TheEryk/PUT-Motorsport-2018-DRS/At90CAN_Atmel/kartapom/kartapom/opis_ramek_can.ods

Sheet: Karta_Pomiarowa
 |  |  |  |  |  |  |  |  |  | BITY | Mnożnik | ID (HEX) | Częstotliwość |  |  |  |  |  |  |  |  |  |  | BITY | Mnożnik | ID (HEX) | Częstotliwość
Tył |  |  |  |  |  |  |  |  |  |  |  |  |  | Przód
1 | A | Prędkość koła PRAWE |  |  |  |  |  |  |  | 16 bitów | 1 | 2 | 20 | 1 | A | Prędkość koła PRAWE |  |  |  |  |  |  |  | 16 bitów | 1 | 1 | 20
 | B | Prędkość koła LEWE |  |  |  |  |  |  |  | 16 bitów | 1 |  |  |  | B | Prędkość koła LEWE |  |  |  |  |  |  |  | 16 bitów | 1
 | C | Amortyzator PRAWY |  |  |  |  |  |  |  | 10 - 16 bitów | 1 |  |  |  | C | Kąt skrętu kierownicy |  |  |  |  |  |  |  | 10 - 16 bitów | 1
 | D | Amortyzator LEWY |  |  |  |  |  |  |  | 10 - 16 bitów | 1 |  |  |  | D | Przełącznik trakcji |  |  |  |  |  |  |  | 4 - 8 bitów | 1
 |  | 0 | 1 | 2 | 3 | 4 | 5 | 6 | 7 |  |  |  |  |  | E | Switch (Brake, G_UP, G_DOWN) |  |  |  |  |  |  |  | 8 bitów | 1
Ramka: |  | A |  | B |  | C |  | D |  |  |  |  |  |  |  | 0 | 1 | 2 | 3 | 4 | 5 | 6 | 7
 |  |  |  |  |  |  |  |  |  |  |  |  |  | Ramka: |  | A |  | B |  | C |  | D | E
Tył |  |  |  |  |  |  |  |  |  |  |  |  |  | Przód
2 | A | Temperatura chłodnicy WEJŚCIE |  |  |  |  |  |  |  | 10 - 16 bitów | 1 | 7 | 10 | 2 | A | Amortyzator PRAWY |  |  |  |  |  |  |  | 10 - 16 bitów | 1 | 6 | 20
 | B | Temperatura chłodnicy WYJŚCIE |  |  |  |  |  |  |  | 10 - 16 bitów | 1 |  |  |  | B | Amortyzator LEWY |  |  |  |  |  |  |  | 10 - 16 bitów | 1
 | C | Ciśnienie paliwa |  |  |  |  |  |  |  | 10 - 16 bitów | 1 |  |  |  | C | Ciśnienie hamulca przód |  |  |  |  |  |  |  | 10 - 16 bitów | 1
 | D | Ciśnienie w układzie hamulcowym |  |  |  |  |  |  |  | 10 - 16 bitów | 1 |  |  |  | D | Ciśnienie hamulca tył |  |  |  |  |  |  |  | 10 - 16 bitów | 1
 |  | 0 | 1 | 2 | 3 | 4 | 5 | 6 | 7 |  |  |  |  |  |  | 0 | 1 | 2 | 3 | 4 | 5 | 6 | 7
Ramka: |  | A |  | B |  | C |  | D |  |  |  |  |  | Ramka: |  | A |  | B |  | C |  | D
Tył |  |  |  |  |  |  |  |  |  |  |  |  |  | Przód
3 | A | Prędkość koła (przeliczone) PRAWE |  |  |  |  |  |  |  | 16 bitów | 1 | 9 | 10 | 3 | A | Prędkość koła (przeliczone) PRAWE |  |  |  |  |  |  |  | 8 bitów | 1 | 8 | 10
 | B | Prędkość koła (przeliczone) LEWE |  |  |  |  |  |  |  | 16 bitów | 1 |  |  |  | B | Prędkość koła (przeliczone) LEWE |  |  |  |  |  |  |  | 8 bitów | 1
 | C |  |  |  |  |  |  |  |  |  |  |  |  |  | C | Kąt skrętu kierownicy (przeliczona) |  |  |  |  |  |  |  | 7 bitów znak | 1
 |  | 0 | 1 | 2 | 3 | 4 | 5 | 6 | 7 |  |  |  |  |  | D | Czy Automatyczna zmiana biegó ACC |  |  |  |  |  |  |  | 8 bit | 1
Ramka: |  | A |  | B |  | C |  |  |  |  |  |  |  |  |  | 0 | 1 | 2 | 3 | 4 | 5 | 6 | 7
Ramka: |  | A |  | B |  | C |  | D | E |  |  |  |  | Ramka: |  | A |  | B |  | C |  | D | E

Sheet: EMU
 |  |  |  |  |  |  |  |  |  | BITY | Mnożnik | ID (HEX) | Częstotliwość | Odbierany stream
EMU |  |  |  |  |  |  |  |  |  |  |  |  |  |  |  |  |  |  |  |  |  |  |  | BITY | ID (HEX)
1 | A | Temperatura oleju |  |  |  |  |  |  |  | 8 bitów | 1 | 5 | 10 | EMU1 karta pomiarowa przód
 | B |  |  |  |  |  |  |  |  |  |  |  |  | 1 | A | Prędkość koła PRAWE |  |  |  |  |  |  |  | 16 bitów | 1
 | C | CLT |  |  |  |  |  |  |  | 16 bitów | 1 |  |  |  | B | Prędkość koła LEWE |  |  |  |  |  |  |  | 16 bitów
 | D | Gear |  |  |  |  |  |  |  | 8 bitów | 1 |  |  |  | C
 |  | 0 | 1 | 2 | 3 | 4 | 5 | 6 | 7 |  |  |  |  |  | D
Ramka: |  | A | B | C |  | D |  |  |  |  |  |  |  |  | E | Sift Switch |  |  |  |  |  |  |  | 8 bitów
 |  |  |  |  |  |  |  |  |  |  |  |  |  |  |  | 0 | 1 | 2 | 3 | 4 | 5 | 6 | 7
 |  |  |  |  |  |  |  |  |  |  |  |  |  | Ramka: |  | A |  | B |  |  |  |  | E
EMU
2 | A | RPM |  |  |  |  |  |  |  | 16 bitów | 1 | 4 | 20 | EMU2 karta pom tył
 | B | TPS |  |  |  |  |  |  |  | 8 bitów | 2 |  |  | 1 | A | Prędkość koła PRAWE |  |  |  |  |  |  |  | 16 bitów | 2
 | C | Ciśnienie oleju |  |  |  |  |  |  |  | 8 bitów | 16 |  |  |  | B | Prędkość koła LEWE |  |  |  |  |  |  |  | 16 bitów
 | D | Lambda |  |  |  |  |  |  |  | 8 bitów | 128 |  |  |  | C
 |  | 0 | 1 | 2 | 3 | 4 | 5 | 6 | 7 |  |  |  |  |  | D
Ramka: |  | A |  | B | C | D |  |  |  |  |  |  |  |  |  | 0 | 1 | 2 | 3 | 4 | 5 | 6 | 7
 |  |  |  |  |  |  |  |  |  |  |  |  |  | Ramka: |  | A |  | B
 |  |  |  |  |  |  |  |  |  |  |  |  |  | EMU3 kontrola trakcji
 |  |  |  |  |  |  |  |  |  |  |  |  |  | 1 | A | Can switch gear up |  |  |  |  |  |  |  | 8 bit | 3
 |  |  |  |  |  |  |  |  |  |  |  |  |  |  | B | Pit limiter (Can SW10) |  |  |  |  |  |  |  | 8bit
 |  |  |  |  |  |  |  |  |  |  |  |  |  |  | C
 |  |  |  |  |  |  |  |  |  |  |  |  |  |  | D
 |  |  |  |  |  |  |  |  |  |  |  |  |  |  |  | 0 | 1 | 2 | 3 | 4 | 5 | 6 | 7
 |  |  |  |  |  |  |  |  |  |  |  |  |  | Ramka: |  | A

Sheet: AIM
 |  |  |  |  |  |  |  |  |  | BITY | mnożnik | ID (HEX) | Częstotliwość
AIM
1 | A | Szerokosc geograficzna |  |  |  |  |  |  |  | 32 bit | 1 | A | 20
 | B | Dlulogść geograficzna |  |  |  |  |  |  |  | 32 bit | 1
 |  | 0 | 1 | 2 | 3 | 4 | 5 | 6 | 7
Ramka: |  | A |  |  |  | B
AIM
1 | A | GPS predkosc |  |  |  |  |  |  |  | 16 bit | 1 | B | 10
 | B | Akcelerometr X |  |  |  |  |  |  |  | 16 bit | 100
 | C | Akcelerometr Y |  |  |  |  |  |  |  | 16 bit | 100
 | D | Akcelerometr Z |  |  |  |  |  |  |  | 16 bit | 100
 |  | 0 | 1 | 2 | 3 | 4 | 5 | 6 | 7
Ramka: |  | A |  | B |  | C |  | D
AIM
1 | A | Napiecie akumulatora |  |  |  |  |  |  |  | 16 bit | 100 | C | 1
 | B | Czas okrazenia |  |  |  |  |  |  |  | 16 bit | 1
 | C | Numer okrążenia |  |  |  |  |  |  |  | 8 bit | 1
 |  | 0 | 1 | 2 | 3 | 4 | 5 | 6 | 7
Ramka: |  | A |  | B |  | C

Sheet: HIERARCHIA
HEX ID |  |  | ID | Name | Nr.
1 | KARTA Przód | 3 | 2 | KARTA Tył | 1
2 | KARTA Przód | 3 | 7 | KARTA Tył | 2
3 | #N/A | #N/A | 1 | KARTA Przód | 1
4 | #N/A | #N/A | 6 | KARTA Przód | 2
5 | #N/A | #N/A | 8 | KARTA Przód | 3
6 | #N/A | #N/A | 5 | EMU | 1
7 | #N/A | #N/A | 4 | EMU | 2
8 | #N/A | #N/A | A | AIM | 1
