TheEryk/PUT-Motorsport-2018-DRS/PCB KiCad/DRS CAN/V2/PDF/B.pdf

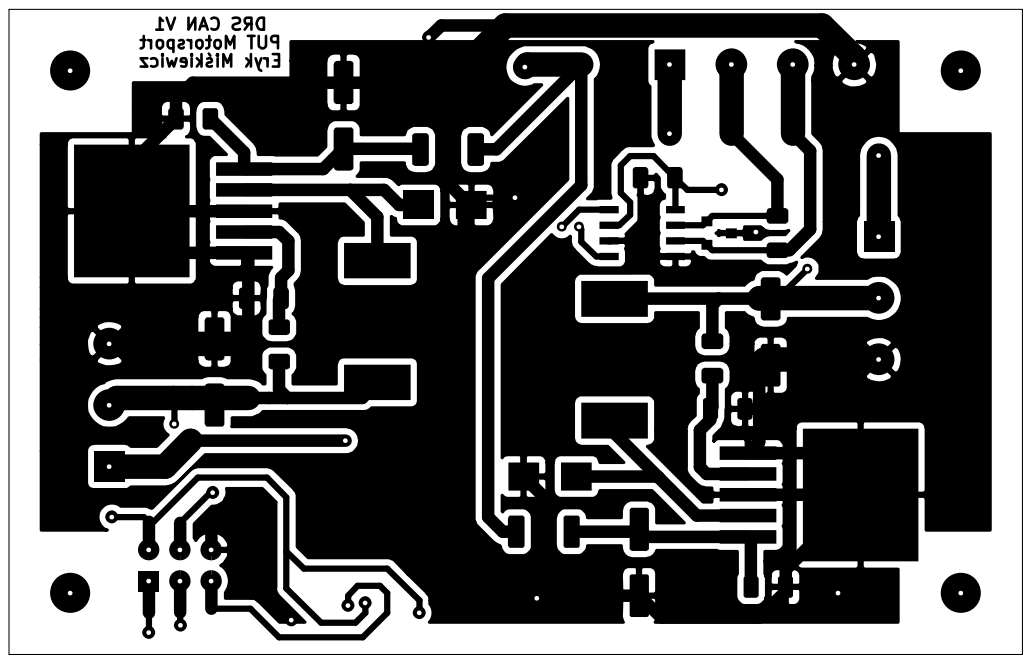
[picture p1: page 1]
