TheEryk/PUT-Motorsport-2018-DRS/PCB KiCad/DRS CAN/V2/PDF/F.pdf

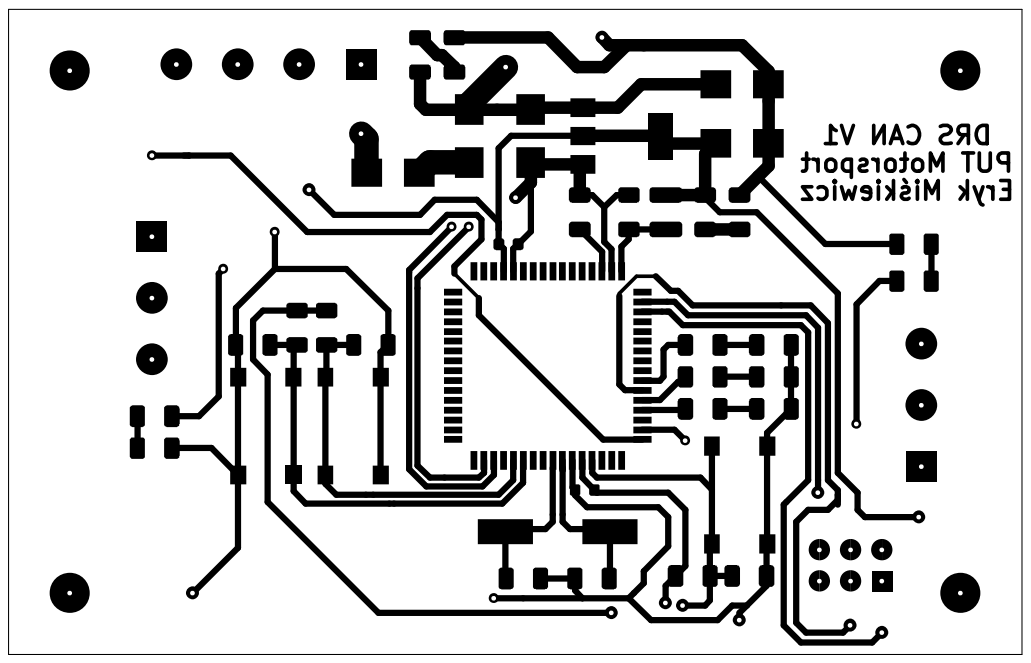
[picture p2: page 1]
