TheEryk/PUT-Motorsport-2018-DRS/PCB KiCad/DRS CAN/V2/PDF/Schemat.pdf

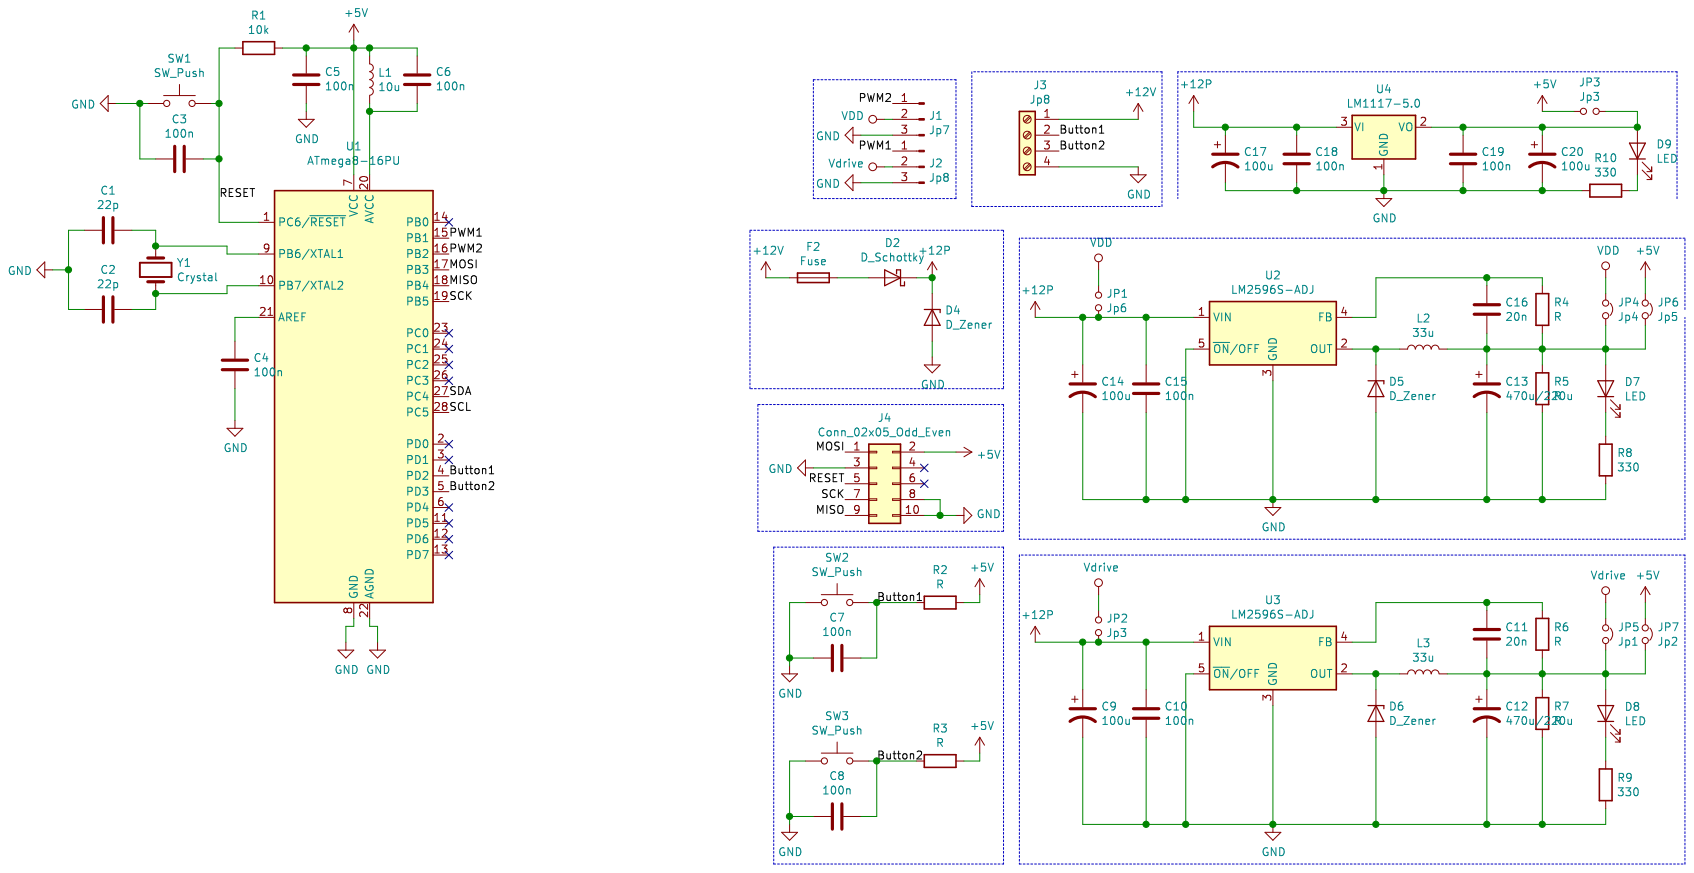
[picture p3: page 1]
