TheEryk/PUT-Motorsport-2018-DRS/PCB KiCad/KartyPomiaroweLegacy/Karta Pomiarowa PCB/karta_pomiarowa-B.Cu.pdf

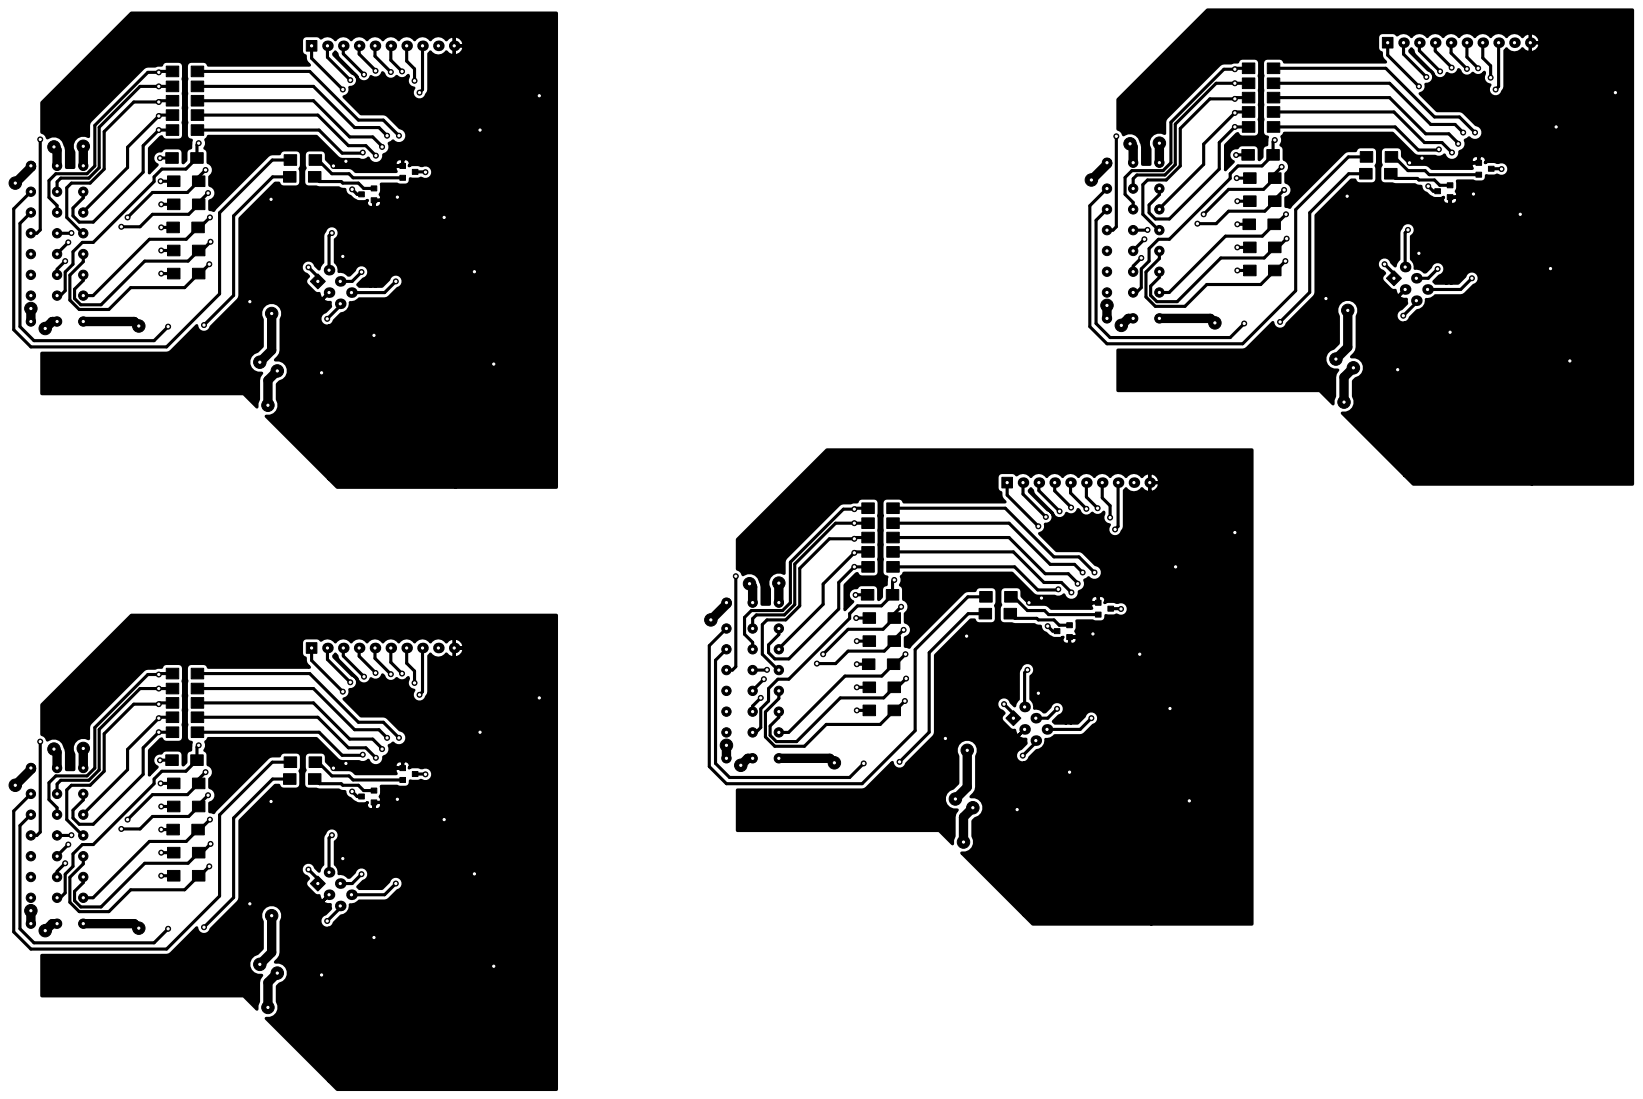
[picture p4: page 1]
