TheEryk/PUT-Motorsport-2018-DRS/PCB KiCad/KartyPomiaroweLegacy/Karta Pomiarowa PCB/karta_pomiarowa-F.Cu.pdf

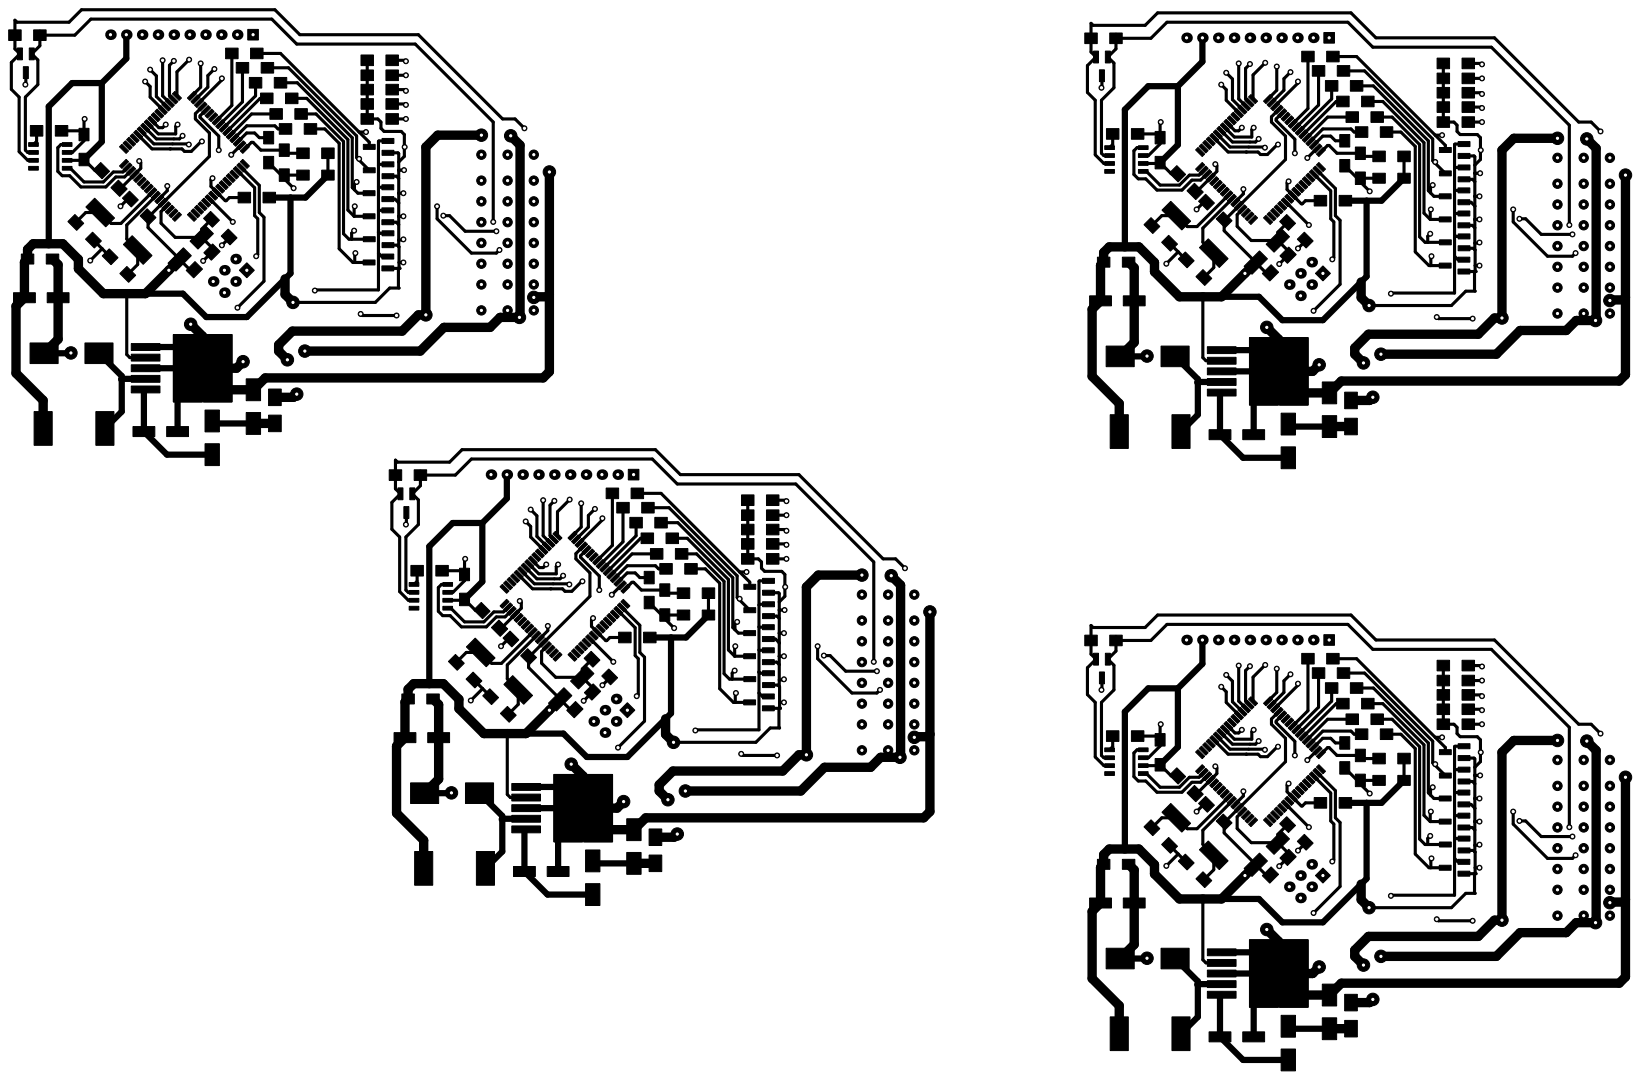
[picture p5: page 1]
