TheEryk/PUT-Motorsport-2018-DRS/PCB KiCad/KartyPomiaroweLegacy/Karta Pomiarowa PCB/karta_pomiarowa.pdf

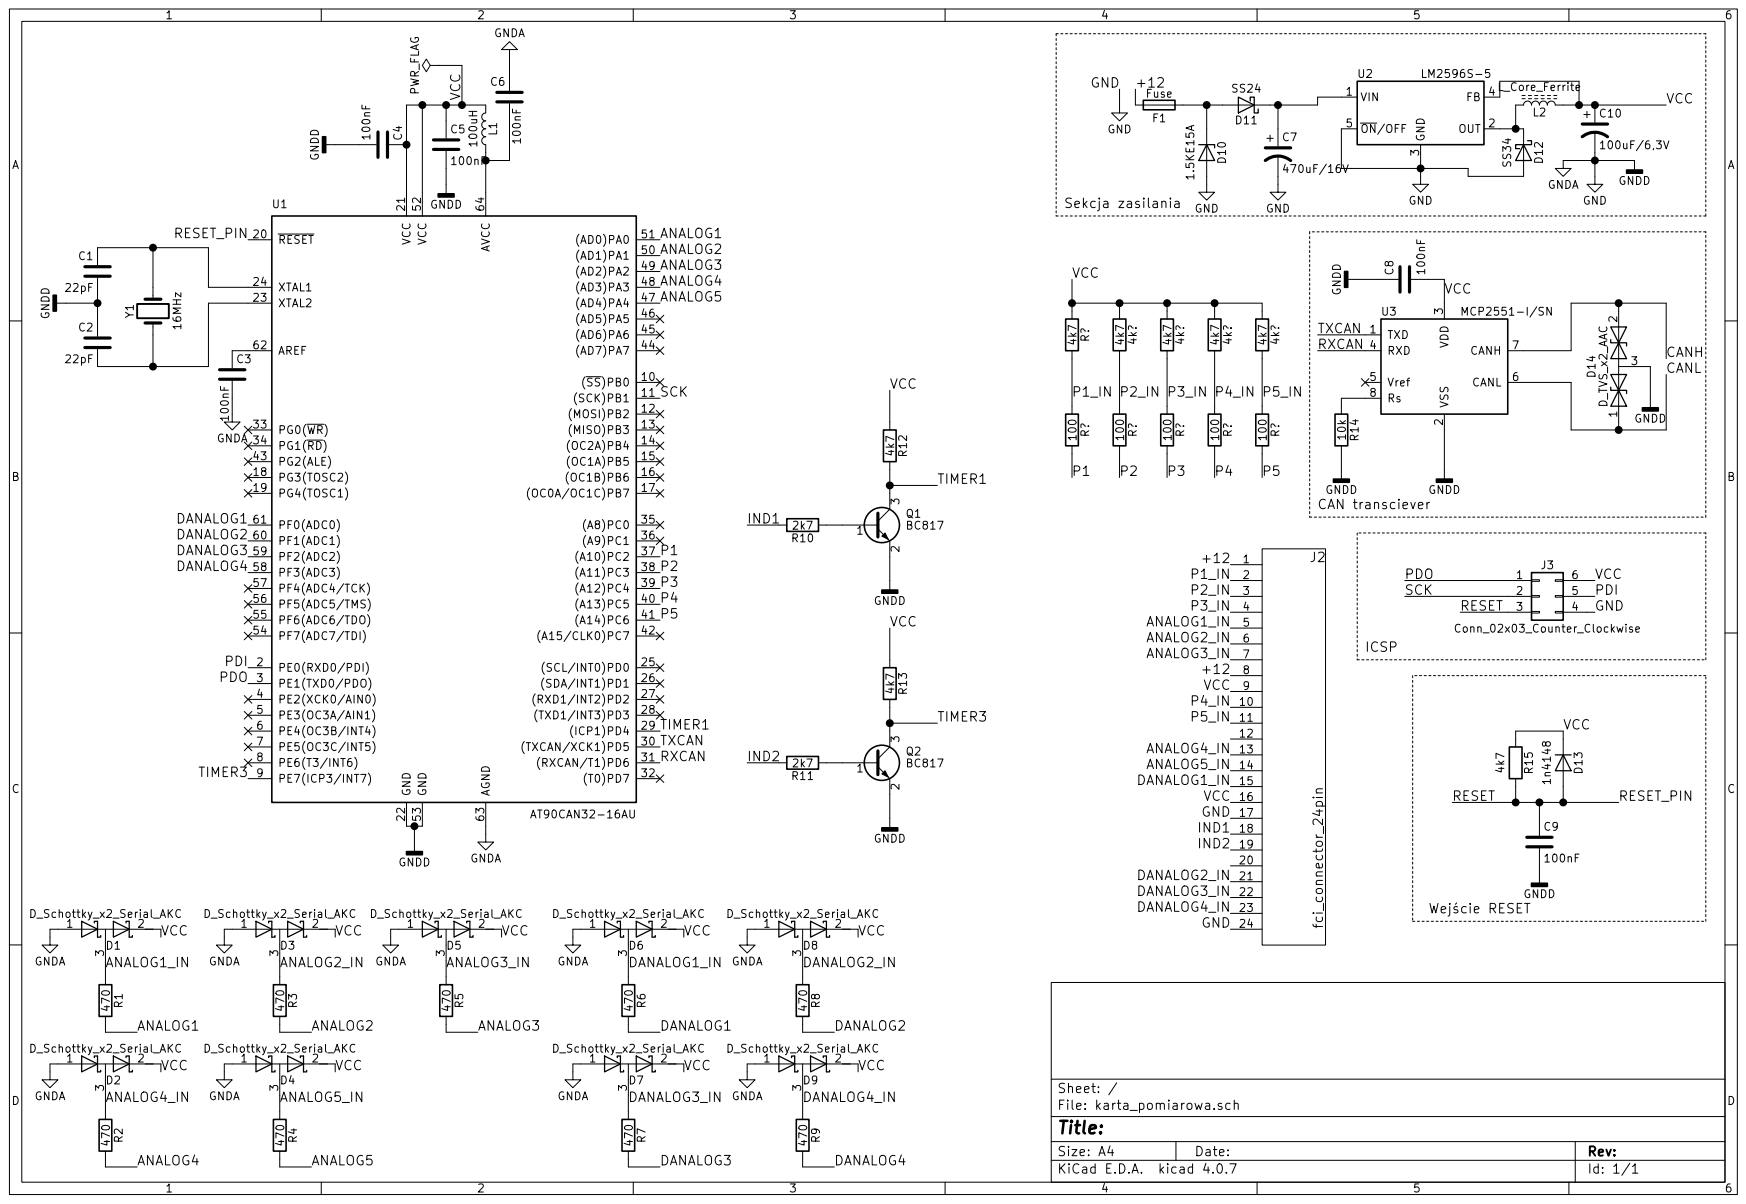
[picture p6: page 1]
