TheEryk/PUT-Motorsport-2018-DRS/PCB KiCad/DRS CAN/V2/DRS.kicad_pcb

## KiCad design PCB KiCad/DRS CAN/V2/DRS.kicad_pcb (2019-07-09)

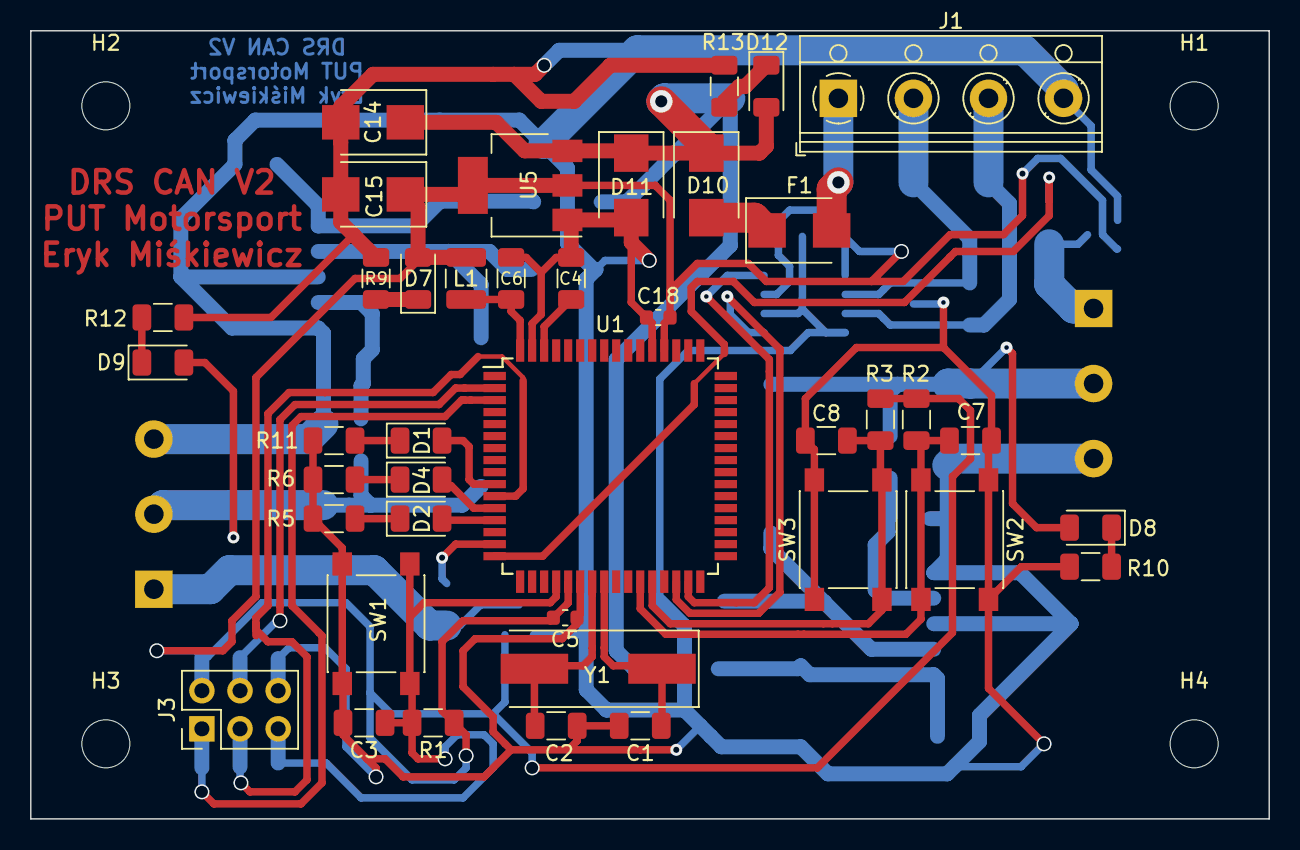
[picture p7: board PCB KiCad/DRS CAN/V2/DRS.kicad_pcb from above]

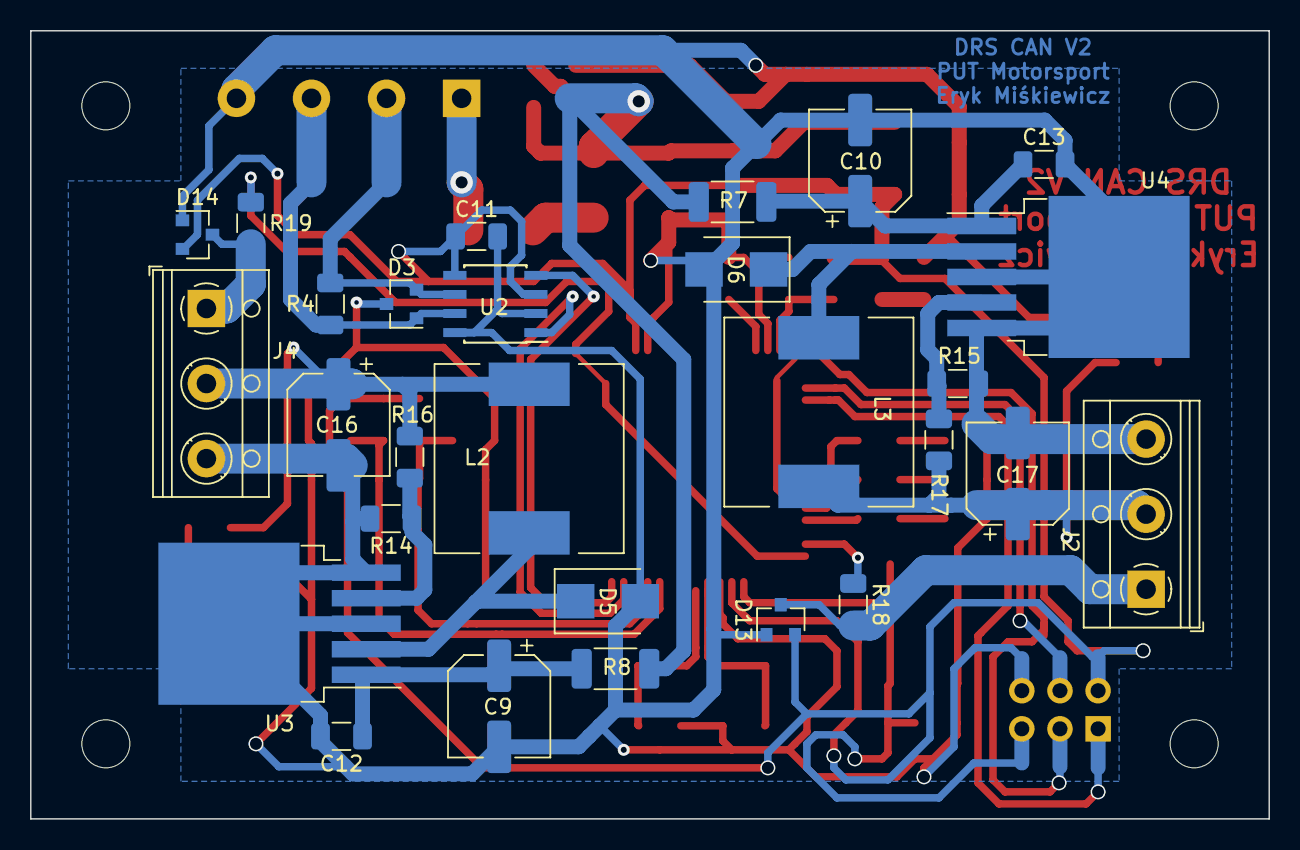
[picture p8: board PCB KiCad/DRS CAN/V2/DRS.kicad_pcb from below]

Board: 2 copper layers, 82.5 x 52.5 mm, 72 parts (28 on the bottom side), 41 nets.

Parts:
C1, C2: 22p; C_1206_3216Metric
C3, C4, C6, C7, C8, C11, C12, C13: 100n; C_1206_3216Metric
C5, C18: 100n; C_0603_1608Metric
C9, C10: 100u; CP_Elec_6.3x7.7
C14, C15: CP; D_SMB
C16, C17: 220u; CP_Elec_6.3x7.7
D1, D2, D4, D7, D8, D9, D12: LED; LED_1206_3216Metric
D3: D_TVS_x2_AAC; SOT-23
D5, D6, D10: D_Schottky; D_SMB
D11: D_Zener; D_SMB
D13, D14: BAT54S; SOT-23
F1: Fuse; D_SMB
H1, H2, H3, H4: MountingHole; MountingHole_3.2mm_M3
J1: Screw_Terminal_01x04; TerminalBlock_RND_205-00014_1x04_P5.00mm_Horizontal
J2, J4: Screw_Terminal_01x03; TerminalBlock_RND_205-00013_1x03_P5.00mm_Horizontal
J3: Conn_02x03_Odd_Even; PinHeader_2x03_P2.54mm_Vertical
L1: 10u; L_1210_3225Metric
L2, L3: 33u; L_12x12mm_H8mm
R1, R2, R3: 10k; R_1206_3216Metric
R4: R_Small; R_1206_3216Metric
R5, R6, R9, R10, R11, R12: 330; R_1206_3216Metric
R7, R8: 0R; R_2010_5025Metric
R13: 2k; R_1206_3216Metric
R14, R15, R16, R17: 0R; R_1206_3216Metric
R18, R19: 1k; R_1206_3216Metric
SW1, SW2, SW3: SW_Push; SW_SPST_PTS645
U1: AT90CAN32-16AU; TQFP-64_14x14mm_P0.8mm
U2: MCP2562-E-SN; SOIC-8_3.9x4.9mm_P1.27mm
U3, U4: AP1501-K5G-13; TO-263-5_TabPin3
U5: LM1117-5.0; SOT-223-3_TabPin2
Y1: Crystal; Crystal_SMD_HC49-SD

Connections:
+5V: C5.2, C11.1, C15.1, C18.2, D7.2, D13.2, D14.2, J3.2, L1.1, R1.1, R2.1, R3.1, U1.21, U1.52, U2.3, U2.5, U5.2
+5VL: C17.1, D9.2, J2.2, L3.2, R17.2
+5VP: C16.1, D8.2, J4.2, L2.2, R16.2
+12P: F1.2, J1.1
+12V: C14.1, D10.1, D11.1, D12.2, R7.2, R8.2, U5.3
/Button1: C7.2, R2.2, SW2.2, U1.27
/Button2: C8.2, R3.2, SW3.2, U1.28
/CANH: D3.1, J1.3, R4.1, U2.7
/CANL: D3.2, J1.2, R4.2, U2.6
/LED1: D1.2, U1.10
/LED2: D4.2, U1.12
/LED3: D2.2, U1.13
/MISO: J3.1, U1.3
/MOSI: J3.4, U1.2
/PWM1: R18.1, U1.15
/PWM2: R19.1, U1.16
/RESET: C3.1, J3.5, R1.2, SW1.2, U1.20
/RXCAN: U1.31, U2.4
/SCK: J3.3, U1.11
/TXCAN: U1.30, U2.1
/Zasilanie/5LU: D6.1, L3.1, U4.2
/Zasilanie/5PU: D5.1, L2.1, U3.2
/Zasilanie/12L: C10.1, C13.1, R7.1, U4.1
/Zasilanie/12P: C9.1, C12.1, R8.1, U3.1
/Złącza/PWM1Out: D13.3, J2.1, R18.2
/Złącza/PWM2Out: D14.3, J4.1, R19.2
GND: C1.2, C2.2, C3.2, C4.2, C5.1, C6.1, C7.1, C8.1, C9.2, C10.2, C11.2, C12.2, C13.2, C14.2, C15.2, C16.2, C17.2, C18.1, D3.3, D5.2, D6.2, D11.2, D13.1, D14.1, J1.4, J2.3, J3.6, J4.3, R5.2, R6.2, R9.2, R10.2, R11.2, R12.2, R13.2, R14.1, R15.1, SW1.1, SW2.1, SW3.1, U1.22, U1.53, U1.63, U2.2, U2.8, U3.3, U3.5, U4.3, U4.5, U5.1
unnamed: C1.1, U1.24, Y1.1
unnamed: C2.1, U1.23, Y1.2
unnamed: C4.1, U1.62
unnamed: C6.2, L1.2, U1.64
unnamed: D1.1, R11.1
unnamed: D2.1, R5.1
unnamed: D4.1, R6.1
unnamed: D7.1, R9.1
unnamed: D8.1, R10.1
unnamed: D9.1, R12.1
unnamed: D10.2, F1.1
unnamed: D12.1, R13.1
unnamed: R14.2, R16.1, U3.4
unnamed: R15.2, R17.1, U4.4
