TheEryk/PUT-Motorsport-2018-DRS/PCB KiCad/DRS CAN/V1/BreakoutFix/BreakOutFix/BreakOutFix.kicad_pcb

## KiCad design PCB KiCad/DRS CAN/V1/BreakoutFix/BreakOutFix/BreakOutFix.kicad_pcb (2019-06-05, an earlier design)

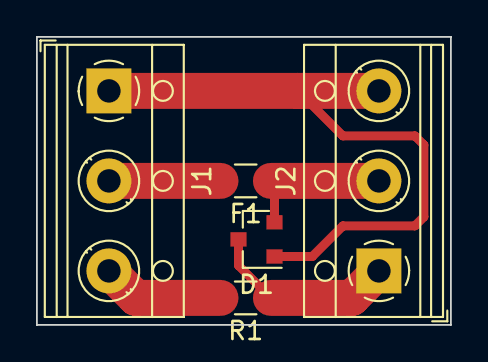
[picture p9: board BreakOutFix.kicad_pcb from above]

Board: 2 copper layers, 23.0 x 16.0 mm, 5 parts (0 on the bottom side), 5 nets.

Parts:
D1: BAT54S; SOT-23
F1: Fuse; Fuse_1206_3216Metric
J1, J2: Screw_Terminal_01x03; TerminalBlock_RND_205-00013_1x03_P5.00mm_Horizontal
R1: R; R_1206_3216Metric

Connections:
+5V: D1.2, F1.1, J2.2
/PWM_IN: D1.3, J2.1, R1.1
/PWM_OUT: J1.3, R1.2
GND: D1.1, J1.1, J2.3
unnamed: F1.2, J1.2
