TheEryk/PUT-Motorsport-2018-DRS/PCB KiCad/DRS DIP V1/DRS.kicad_pcb

## KiCad design PCB KiCad/DRS DIP V1/DRS.kicad_pcb (2019-05-12)

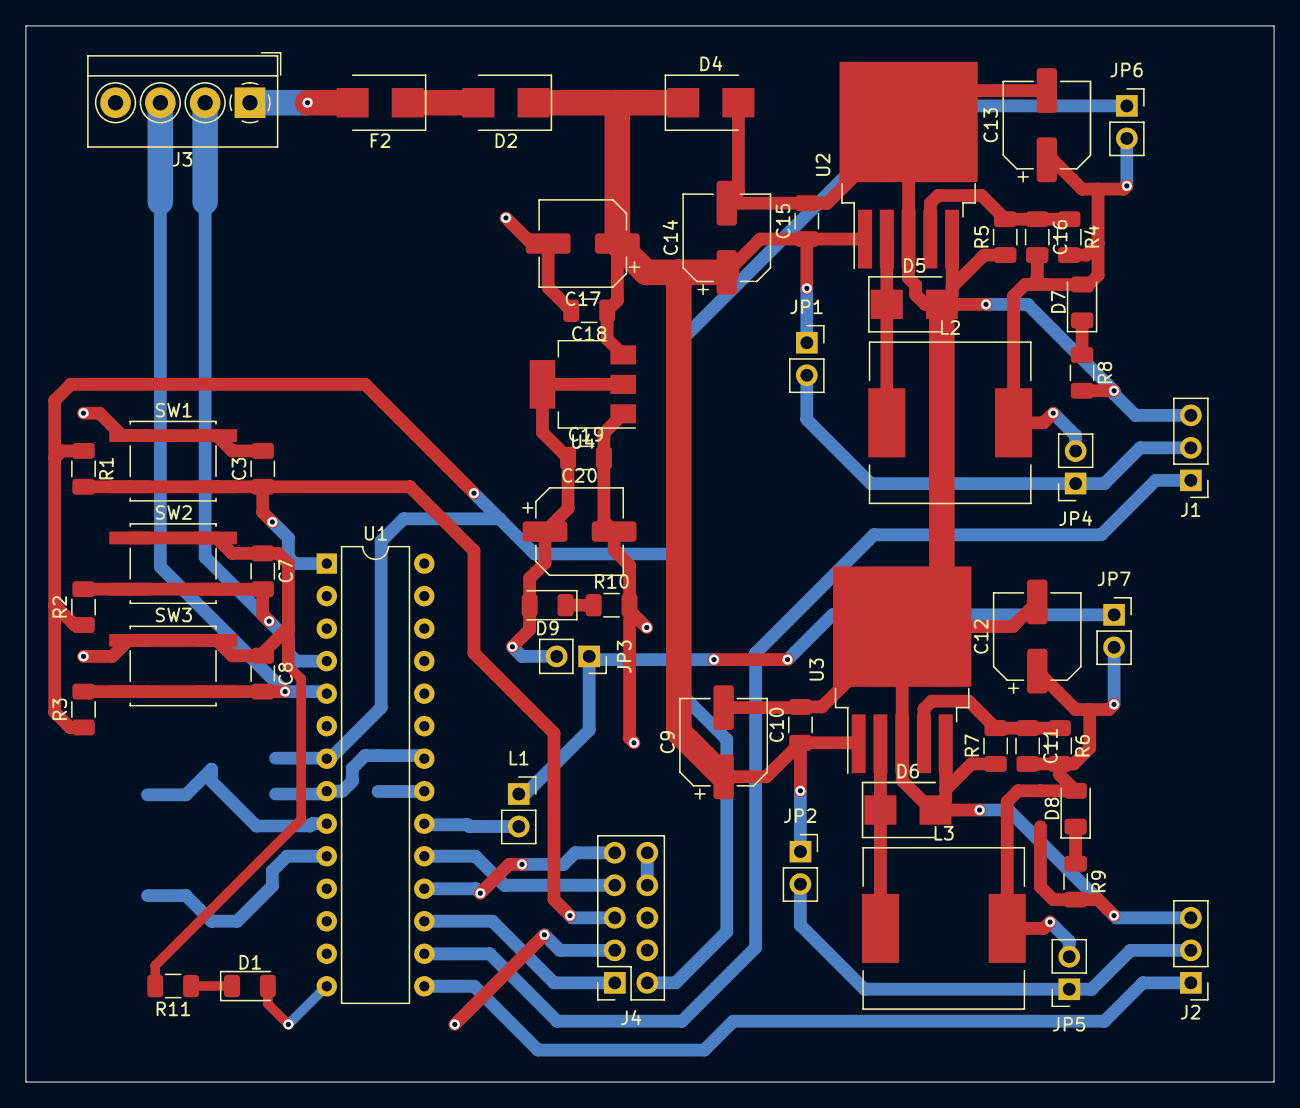
[picture p10: board PCB KiCad/DRS DIP V1/DRS.kicad_pcb from above]

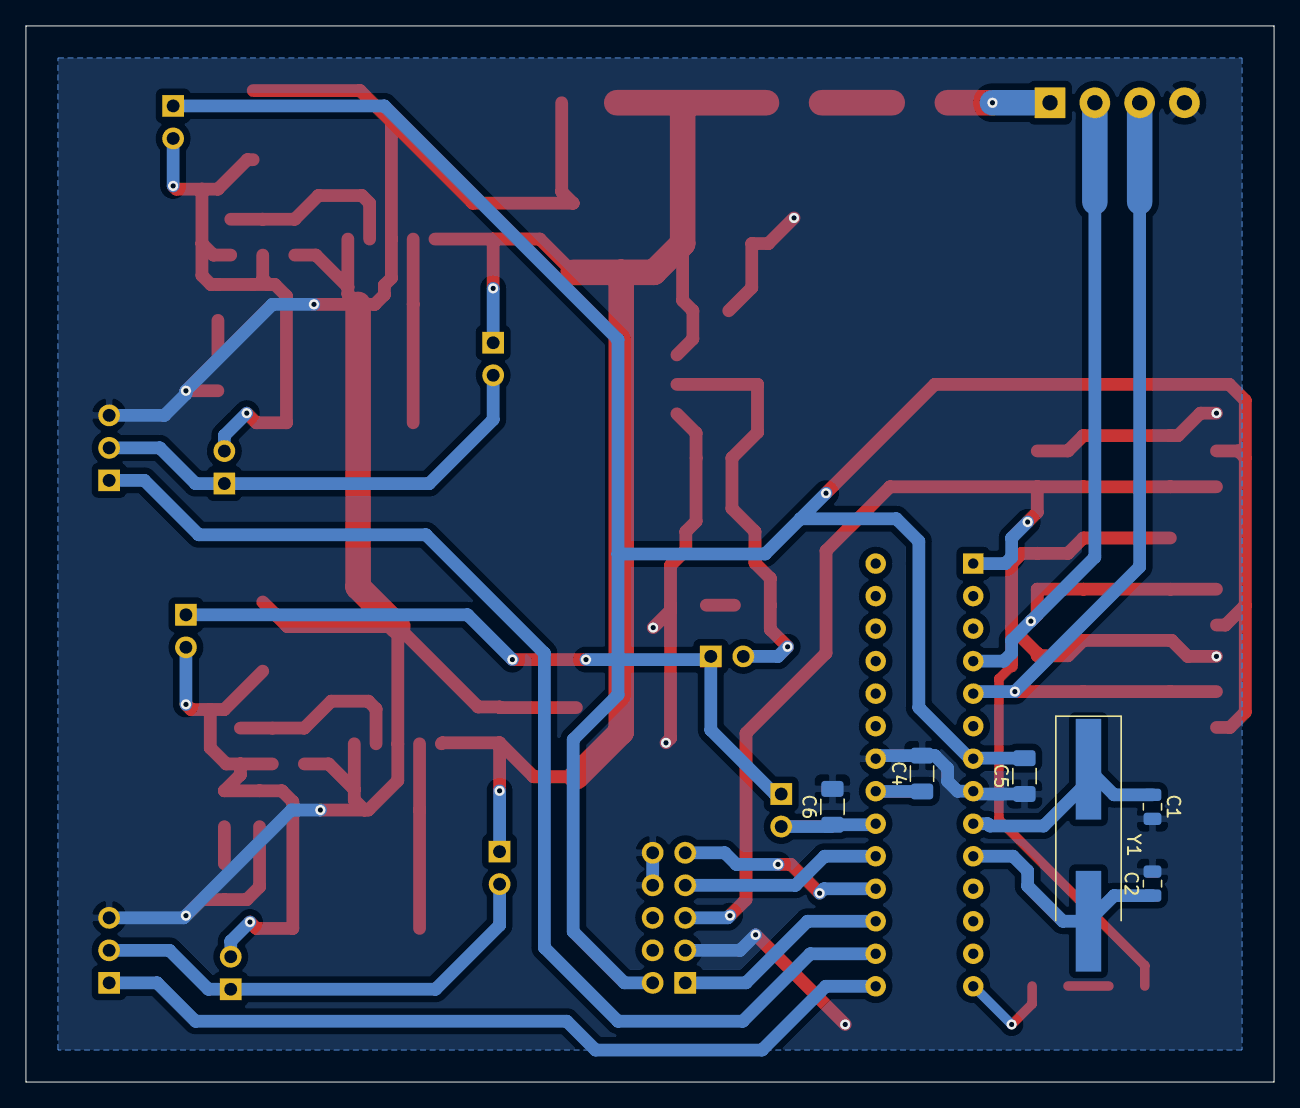
[picture p11: board PCB KiCad/DRS DIP V1/DRS.kicad_pcb from below]

Board: 2 copper layers, 97.5 x 82.5 mm, 62 parts (6 on the bottom side), 31 nets.

Parts:
C1, C2: 22p; C_0805_2012Metric
C3, C4, C5, C6, C7, C8, C10, C15, C18, C19: 100n; C_1206_3216Metric
C9, C14, C17, C20: 100u; CP_Elec_6.3x7.7
C11, C16: 20n; C_1206_3216Metric
C12, C13: 470u/220u; CP_Elec_6.3x7.7
D1, D7, D8, D9: LED; LED_1206_3216Metric
D2: D_Schottky; D_SMB
D4, D5, D6: D_Zener; D_SMB
F2: Fuse; D_SMB
J1: Jp7; PinHeader_1x03_P2.54mm_Vertical
J2: Jp8; PinHeader_1x03_P2.54mm_Vertical
J3: Jp8; TerminalBlock_4Ucon_1x04_P3.50mm_Horizontal
J4: Conn_02x05_Odd_Even; PinSocket_2x05_P2.54mm_Vertical
JP1: Jp6; PinSocket_1x02_P2.54mm_Vertical
JP2, JP3: Jp3; PinSocket_1x02_P2.54mm_Vertical
JP4: Jp4; PinSocket_1x02_P2.54mm_Vertical
JP5: Jp1; PinSocket_1x02_P2.54mm_Vertical
JP6: Jp5; PinSocket_1x02_P2.54mm_Vertical
JP7: Jp2; PinSocket_1x02_P2.54mm_Vertical
L1: 10u; PinSocket_1x02_P2.54mm_Vertical
L2, L3: 33u; L_12x12mm_H8mm
R1: 10k; R_1206_3216Metric
R2, R3, R4, R5, R6, R7: R; R_1206_3216Metric
R8, R9, R10, R11: 330; R_1206_3216Metric
SW1, SW2, SW3: SW_Push; SW_SPST_EVQQ2
U1: ATmega8-16PU; DIP-28_W7.62mm
U2, U3: LM2596S-ADJ; TO-263-5_TabPin3
U4: LM1117-5.0; SOT-223-3_TabPin2
Y1: Crystal; Crystal_SMD_HC49-SD_HandSoldering

Connections:
+5V: C5.2, J4.2, JP3.1, JP6.1, JP7.1, L1.1, R1.1, R2.1, R3.1, U1.7
+12P: C9.1, C10.1, C14.1, C15.1, C17.1, C18.1, D2.1, D4.1, JP1.1, JP2.1, U2.1, U3.1, U4.3
+12V: F2.2, J3.1
/Button1: C7.2, J3.2, R2.2, SW2.2, U1.4
/Button2: C8.2, J3.3, R3.2, SW3.2, U1.5
/LED: D1.2, U1.14
/MISO: J4.9, U1.18
/MOSI: J4.1, U1.17
/PWM1: J2.1, U1.15
/PWM2: J1.1, U1.16
/RESET: C3.1, J4.5, R1.2, SW1.2, U1.1
/SCK: J4.7, U1.19
GND: C1.2, C2.2, C3.2, C4.2, C5.1, C6.2, C7.1, C8.1, C9.2, C10.2, C12.2, C13.2, C14.2, C15.2, C17.2, C18.2, C19.2, C20.2, D4.2, D5.2, D6.2, J1.3, J2.3, J3.4, J4.3, J4.8, J4.10, R5.1, R7.1, R8.2, R9.2, R10.2, R11.2, SW1.1, SW2.1, SW3.1, U1.8, U1.22, U2.3, U2.5, U3.3, U3.5, U4.1
unnamed: C1.1, U1.9, Y1.1
unnamed: C2.1, U1.10, Y1.2
unnamed: C4.1, U1.21
unnamed: C6.1, L1.2, U1.20
unnamed: C11.1, R6.1, R7.2, U3.4
unnamed: C11.2, C12.1, D8.2, JP5.2, JP7.2, L3.2, R6.2
unnamed: C13.1, C16.2, D7.2, JP4.2, JP6.2, L2.2, R4.2
unnamed: C16.1, R4.1, R5.2, U2.4
unnamed: C19.1, C20.1, D9.2, JP3.2, U4.2
unnamed: D1.1, R11.1
unnamed: D2.2, F2.1
unnamed: D5.1, L2.1, U2.2
unnamed: D6.1, L3.1, U3.2
unnamed: D7.1, R8.1
unnamed: D8.1, R9.1
unnamed: D9.1, R10.1
VDD: J1.2, JP1.2, JP4.1
Vdrive: J2.2, JP2.2, JP5.1
