TheEryk/PUT-Motorsport-2018-DRS/PCB KiCad/KartyPomiaroweLegacy/Karta Pomiarowa PCB/karta_pomiarowa.kicad_pcb

## KiCad design PCB KiCad/KartyPomiaroweLegacy/Karta Pomiarowa PCB/karta_pomiarowa.kicad_pcb (2019-04-14, an earlier design)

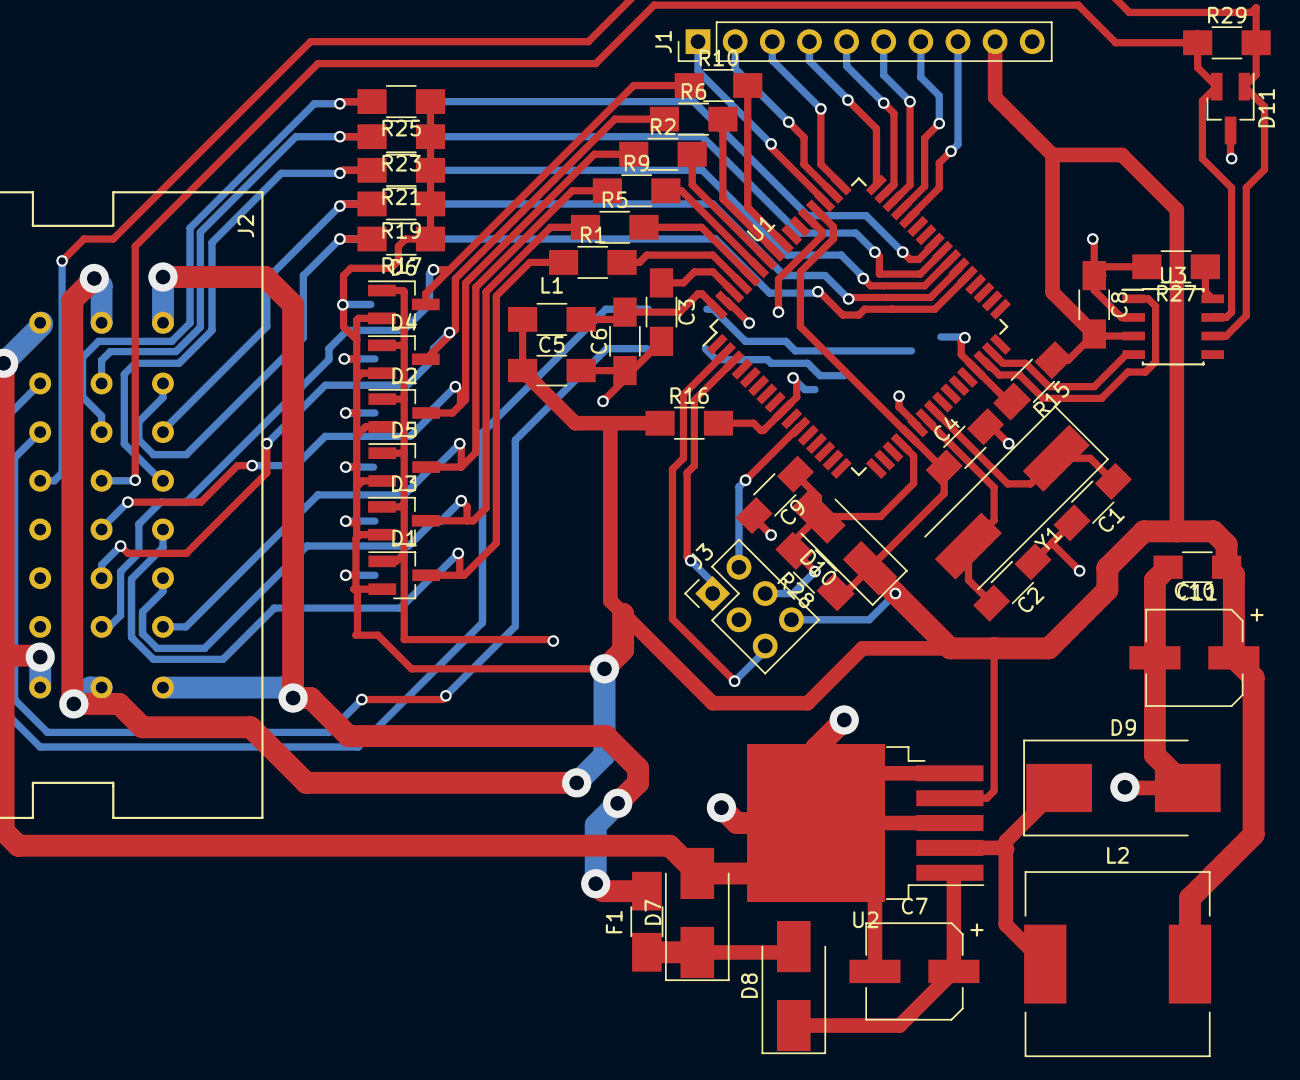
[picture p12: board karta_pomiarowa.kicad_pcb from above]

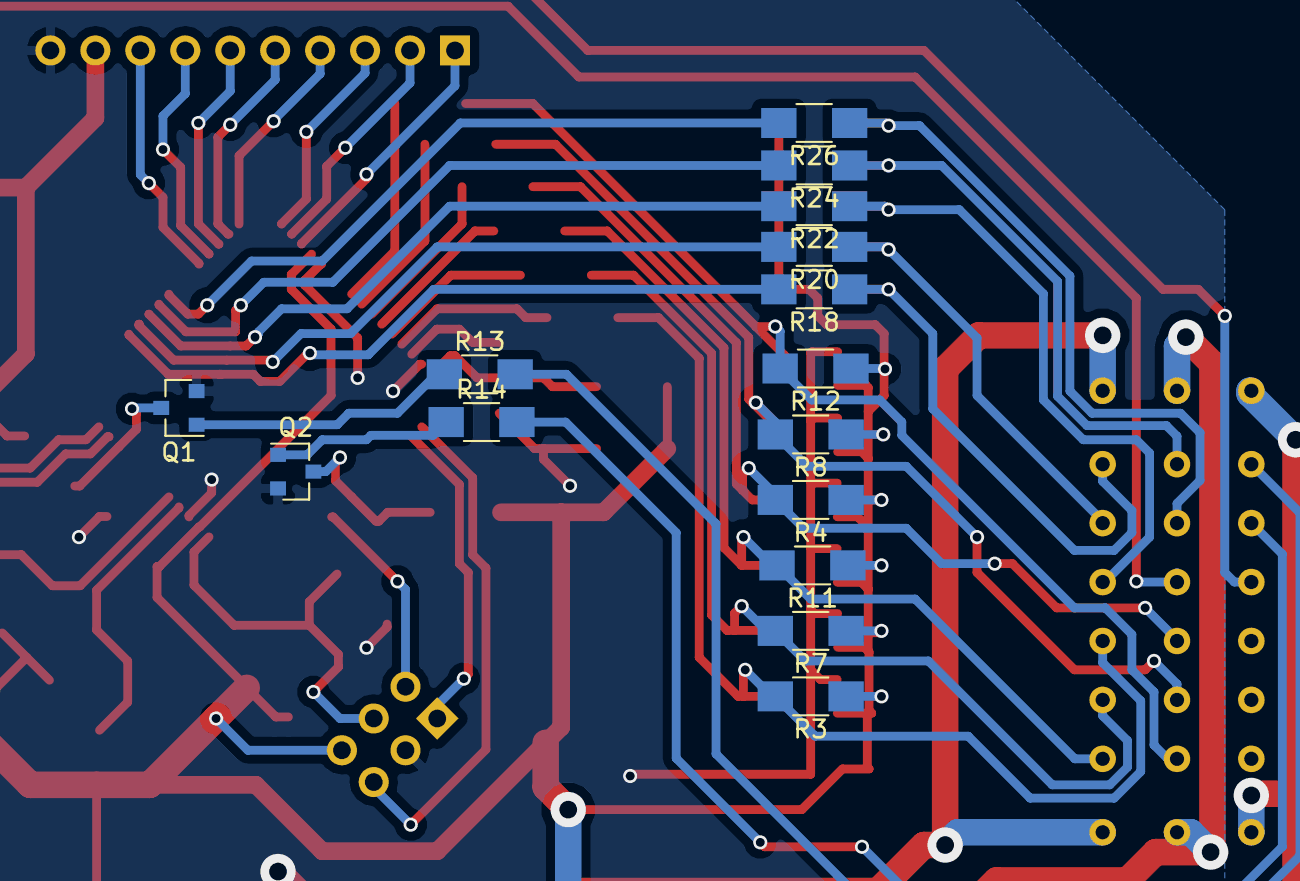
[picture p13: board karta_pomiarowa.kicad_pcb from below]

Board: 2 copper layers, 63 parts (15 on the bottom side), 55 nets.

Parts:
C1, C2: 22pF; C_1206_HandSoldering
C3, C4, C5, C6, C8, C9, C11: 100nF; C_1206_HandSoldering
C7: 470uF/16V; CP_Elec_6.3x7.7
C10: 100uF/6,3V; CP_Elec_6.3x5.8
D1, D2, D3, D4, D5, D6: BAT54S; SOT-23_Handsoldering
D7: SMBJ14CA; D_SMB_Handsoldering
D8: SS24; D_SMB_Handsoldering
D9: SS34; D_SMC_Handsoldering
D10: 1n4148; D_SMA_Handsoldering
D11: SM712; SOT-23_Handsoldering
F1: Fuse; Fuse_SMD1206_HandSoldering
J1: Conn_01x10; Pin_Header_Straight_1x10_Pitch2.54mm
J2: fci_connector_24pin
J3: Conn_02x03_Counter_Clockwise; Pin_Header_Straight_2x03_Pitch2.54mm
L1: 10uH; L_1206_HandSoldering
L2: 33uH/3A; L_12x12mm_h8mm
Q1, Q2: BC817; SOT-23
R1, R2, R5, R6, R9, R10: 470; R_1206_HandSoldering
R3, R4, R7, R8, R11, R12, R15, R16, R17, R19, R21, R23, R25, R28: 4k7; R_1206_HandSoldering
R13, R14: 2k7; R_1206_HandSoldering
R18, R20, R22, R24, R26: 100; R_1206_HandSoldering
R27: 10k; R_1206_HandSoldering
R29: 120; R_1206_HandSoldering
U1: AT90CAN32-16AU; TQFP-64_14x14mm_Pitch0.8mm
U2: LM2596S-5; TO-263-5_TabPin3
U3: MCP2551-I/SN; SOIC-8_3.9x4.9mm_Pitch1.27mm
Y1: 16MHz; Crystal_SMD_HC49-SD

Connections:
/+12: F1.2, J2.1, J2.8
/ANALOG1: R1.2, U1.61
/ANALOG1_IN: D1.3, J2.5, R1.1, R3.2
/ANALOG2: R5.2, U1.60
/ANALOG2_IN: D3.3, J2.6, R5.1, R7.2
/ANALOG3: R9.2, U1.59
/ANALOG3_IN: D5.3, J2.7, R9.1, R11.2
/ANALOG4: R2.2, U1.58
/ANALOG4_IN: D2.3, J2.13, R2.1, R4.2
/ANALOG5: R6.2, U1.57
/ANALOG5_IN: D4.3, J2.14, R6.1, R8.2
/ANALOG6: R10.2, U1.56
/ANALOG6_IN: D6.3, J2.15, R10.1, R12.2
/CANH: D11.2, J2.12, R29.1, U3.7
/CANL: D11.1, J2.20, R29.2, U3.6
/External_Analog0: J1.1, U1.51
/External_Analog1: J1.2, U1.50
/External_Analog2: J1.3, U1.49
/External_Analog3: J1.4, U1.48
/External_Analog4: J1.5, U1.47
/External_Analog5: J1.6, U1.46
/External_Analog6: J1.7, U1.45
/External_Analog7: J1.8, U1.44
/IND1: J2.18, R13.2
/IND2: J2.19, R14.2
/P1: R18.2, U1.37
/P1_IN: J2.2, R17.2, R18.1
/P2: R20.2, U1.38
/P2_IN: J2.3, R19.2, R20.1
/P3: R22.2, U1.39
/P3_IN: J2.4, R21.2, R22.1
/P4: R24.2, U1.40
/P4_IN: J2.10, R23.2, R24.1
/P5: R26.2, U1.41
/P5_IN: J2.11, R25.2, R26.1
/PDI: J3.5, U1.2
/PDO: J3.1, U1.3
/RESET: C9.1, D10.2, J3.4, R28.2, U1.20
/RXCAN: U1.31, U3.4
/SCK: J3.2, U1.11
/TIMER1: Q1.3, R15.2, U1.29
/TIMER3: Q2.3, R16.2, U1.9
/TXCAN: U1.30, U3.1
/VCC: C4.1, C5.1, C8.2, C10.1, C11.1, D1.2, D2.2, D3.2, D4.2, D5.2, D6.2, D10.1, J1.9, J2.9, J2.16, J3.6, L1.1, L2.2, R3.1, R4.1, R7.1, R8.1, R11.1, R12.1, R15.1, R16.1, R17.1, R19.1, R21.1, R23.1, R25.1, R28.1, U1.21, U1.52, U2.4, U3.3
GND: C1.2, C2.1, C3.2, C4.2, C5.2, C6.1, C7.2, C8.1, C9.2, C10.2, C11.2, D1.1, D2.1, D3.1, D4.1, D5.1, D6.1, D7.2, D9.2, D11.3, J1.10, J2.17, J2.24, J3.3, Q1.2, Q2.2, R27.2, U1.22, U1.53, U1.63, U2.3, U2.5, U3.2
unnamed: C1.1, U1.24, Y1.1
unnamed: C2.2, U1.23, Y1.2
unnamed: C3.1, U1.62
unnamed: C6.2, L1.2, U1.64
unnamed: C7.1, D8.1, U2.1
unnamed: D7.1, D8.2, F1.1
unnamed: D9.1, L2.1, U2.2
unnamed: Q1.1, R13.1
unnamed: Q2.1, R14.1
unnamed: R27.1, U3.8
