TheEryk/PUT-Motorsport-2018-DRS/At90CAN_Atmel/kartapom/kartapom/config.h

/*
 * May 2018
 *
 * Mieszko Mazurek <mimaz@gmx.com>
 *
 * Poznan University of Technology
 */

#ifndef __config_h
#define __config_h

#define LED_PIN 0
#define DISPLAY_RS_PIN 2
#define DISPLAY_EN_PIN 3
#define DISPLAY_D4_PIN 4
#define DISPLAY_D5_PIN 5
#define DISPLAY_D6_PIN 6
#define DISPLAY_D7_PIN 7

#define SPEED_OVF_SKIP 1
#define SPEED_SMOOTH_LV 0

//#define DEBUG

#endif
