TheEryk/PUT-Motorsport-2018-DRS/(commit log)

2019-04-14 04_14 CAN v1
    [DRS.kicad_pcb, DRS.sch]
2019-04-14 04_14 CANv2
    [DRS.kicad_pcb, DRS.sch, convertcsv (1).xlsx, karta_pomiarowa-2019-04-14-15-49-44.sch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]
2019-04-14 04_14 fix1
    [DRS.kicad_pcb, DRS.sch]
2019-05-05 05_05 v2
    Skończony projekt testowy na at90can
    [DRS.kicad_pcb, DRS.sch, karta_pomiarowa-2019-05-05-10-59-19.sch]
2019-05-11 At90can v1
    Zaprojektowano nowe PCB na bolid
    [DRS.kicad_pcb, DRS.sch, Zasilanie.sch, Złącza.sch]
2019-05-12 Code cleanup
    [opis_ramek_can.ods, opis_ramek_can.xlsx]
2019-05-12 Adjustable voltage fix
    [DRS.kicad_pcb, DRS.sch, Zasilanie.sch, Złącza.sch]
2019-05-16 ustawienie poczatkowej wartosci pwm, nalezy jeszcze ustawic odpowiednia czestotliwosc
2019-05-31 Dodana funkcja PWM servo, przykladowa obsluga drs'u po Canie
2019-06-05 Dodano płytkę z zabezpieczeniem wyjść
    [BreakOutFix.kicad_pcb, BreakOutFix.sch]
2019-06-07 WersjaV2 PCB
    [BreakOutFix.kicad_pcb, BreakOutFix.sch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]
2019-06-29 Updated brake's frame
2019-06-29 DRS is open when button is pushed and no brake
2019-06-29 DRS is open when button is pushed, closed when button is released, closed when braking, closed when CAN signal is lost
2019-07-01 Button from bit3 to bit2, good pwm vaules
2019-07-02 tested, good todo: set PWM values for drs assembly on car, add menu - easier pwm settings
